lukaskaplan/FireTruck/arduino-shield/PCB_bottom.png

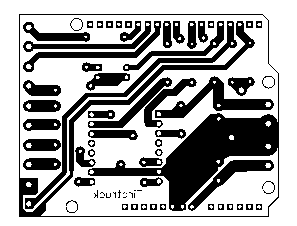
arduino-shield/PCB_bottom.png
