lukaskaplan/FireTruck/(threads)

Thread 1 (2019-04-08):

Horn does not work after engine sound stops.

lukaskaplan, 2019-04-08:
Dfplayer "advert" does not play sound if there is nothing playing in the background (engine sound in this case). Solution can be play engine sound in loop.
