lukaskaplan/FireTruck/arduino-shield/Schematic_Firetruck - arduino uno shield.pdf

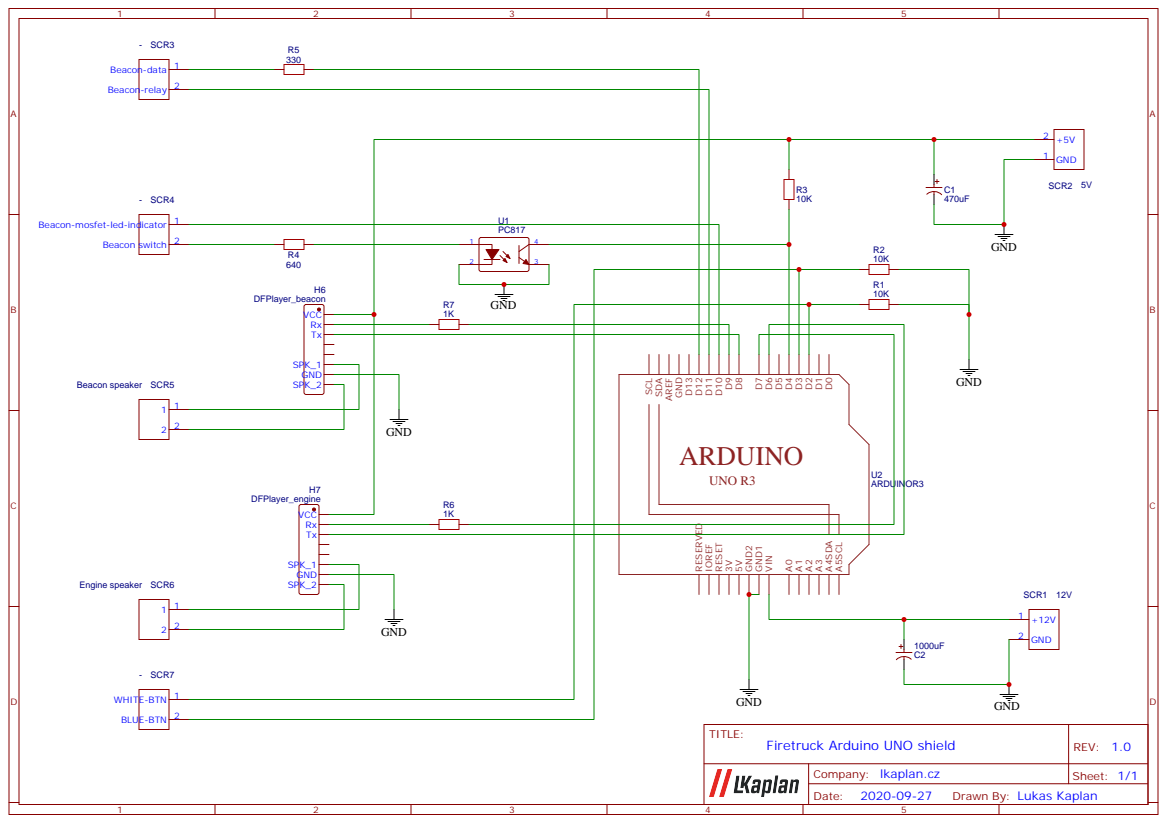
[picture p24: page 1]

Beacon-mosfet-led-indicator 1

Drawn By: Lukas Kaplan
