lukaskaplan/FireTruck/schematics/FireTruck-schematics.pdf

# Rear lights

# Rear inside lights

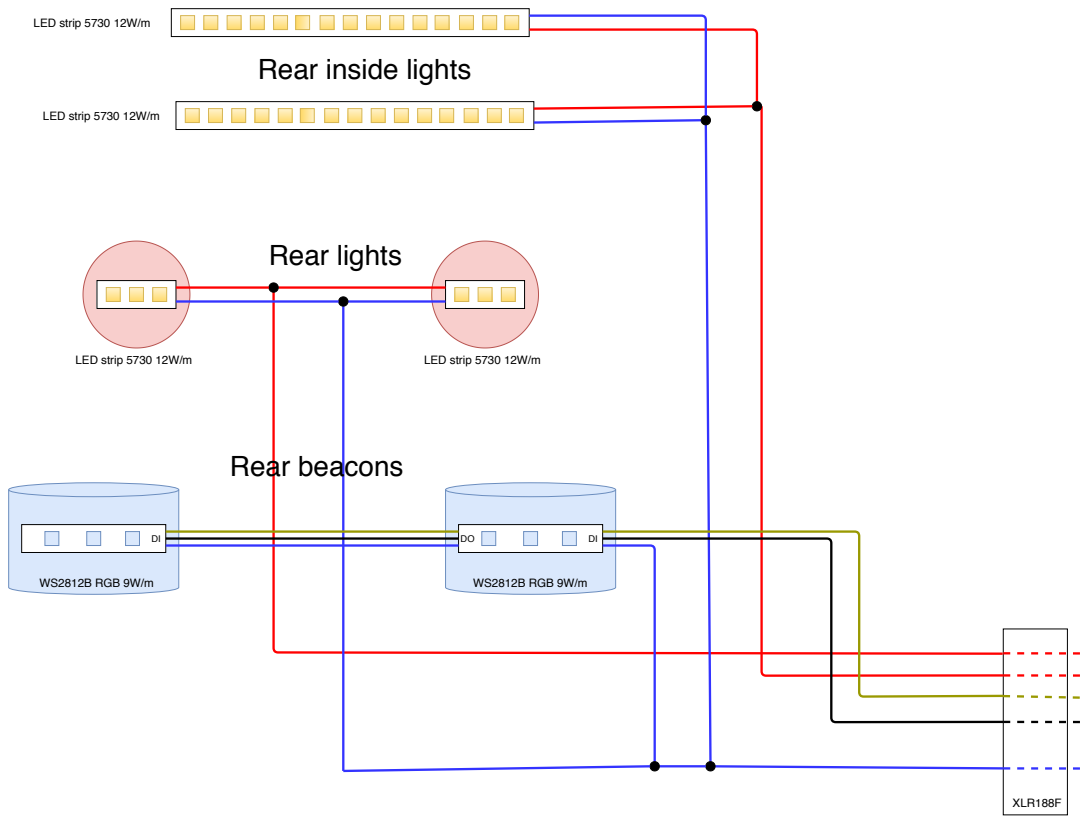
[picture p25: page 1]
WS2812B RGB 9W/m; Rear beacons; XLR188F; LED strip 5730 12W/m

# Front lights

# Front inside light

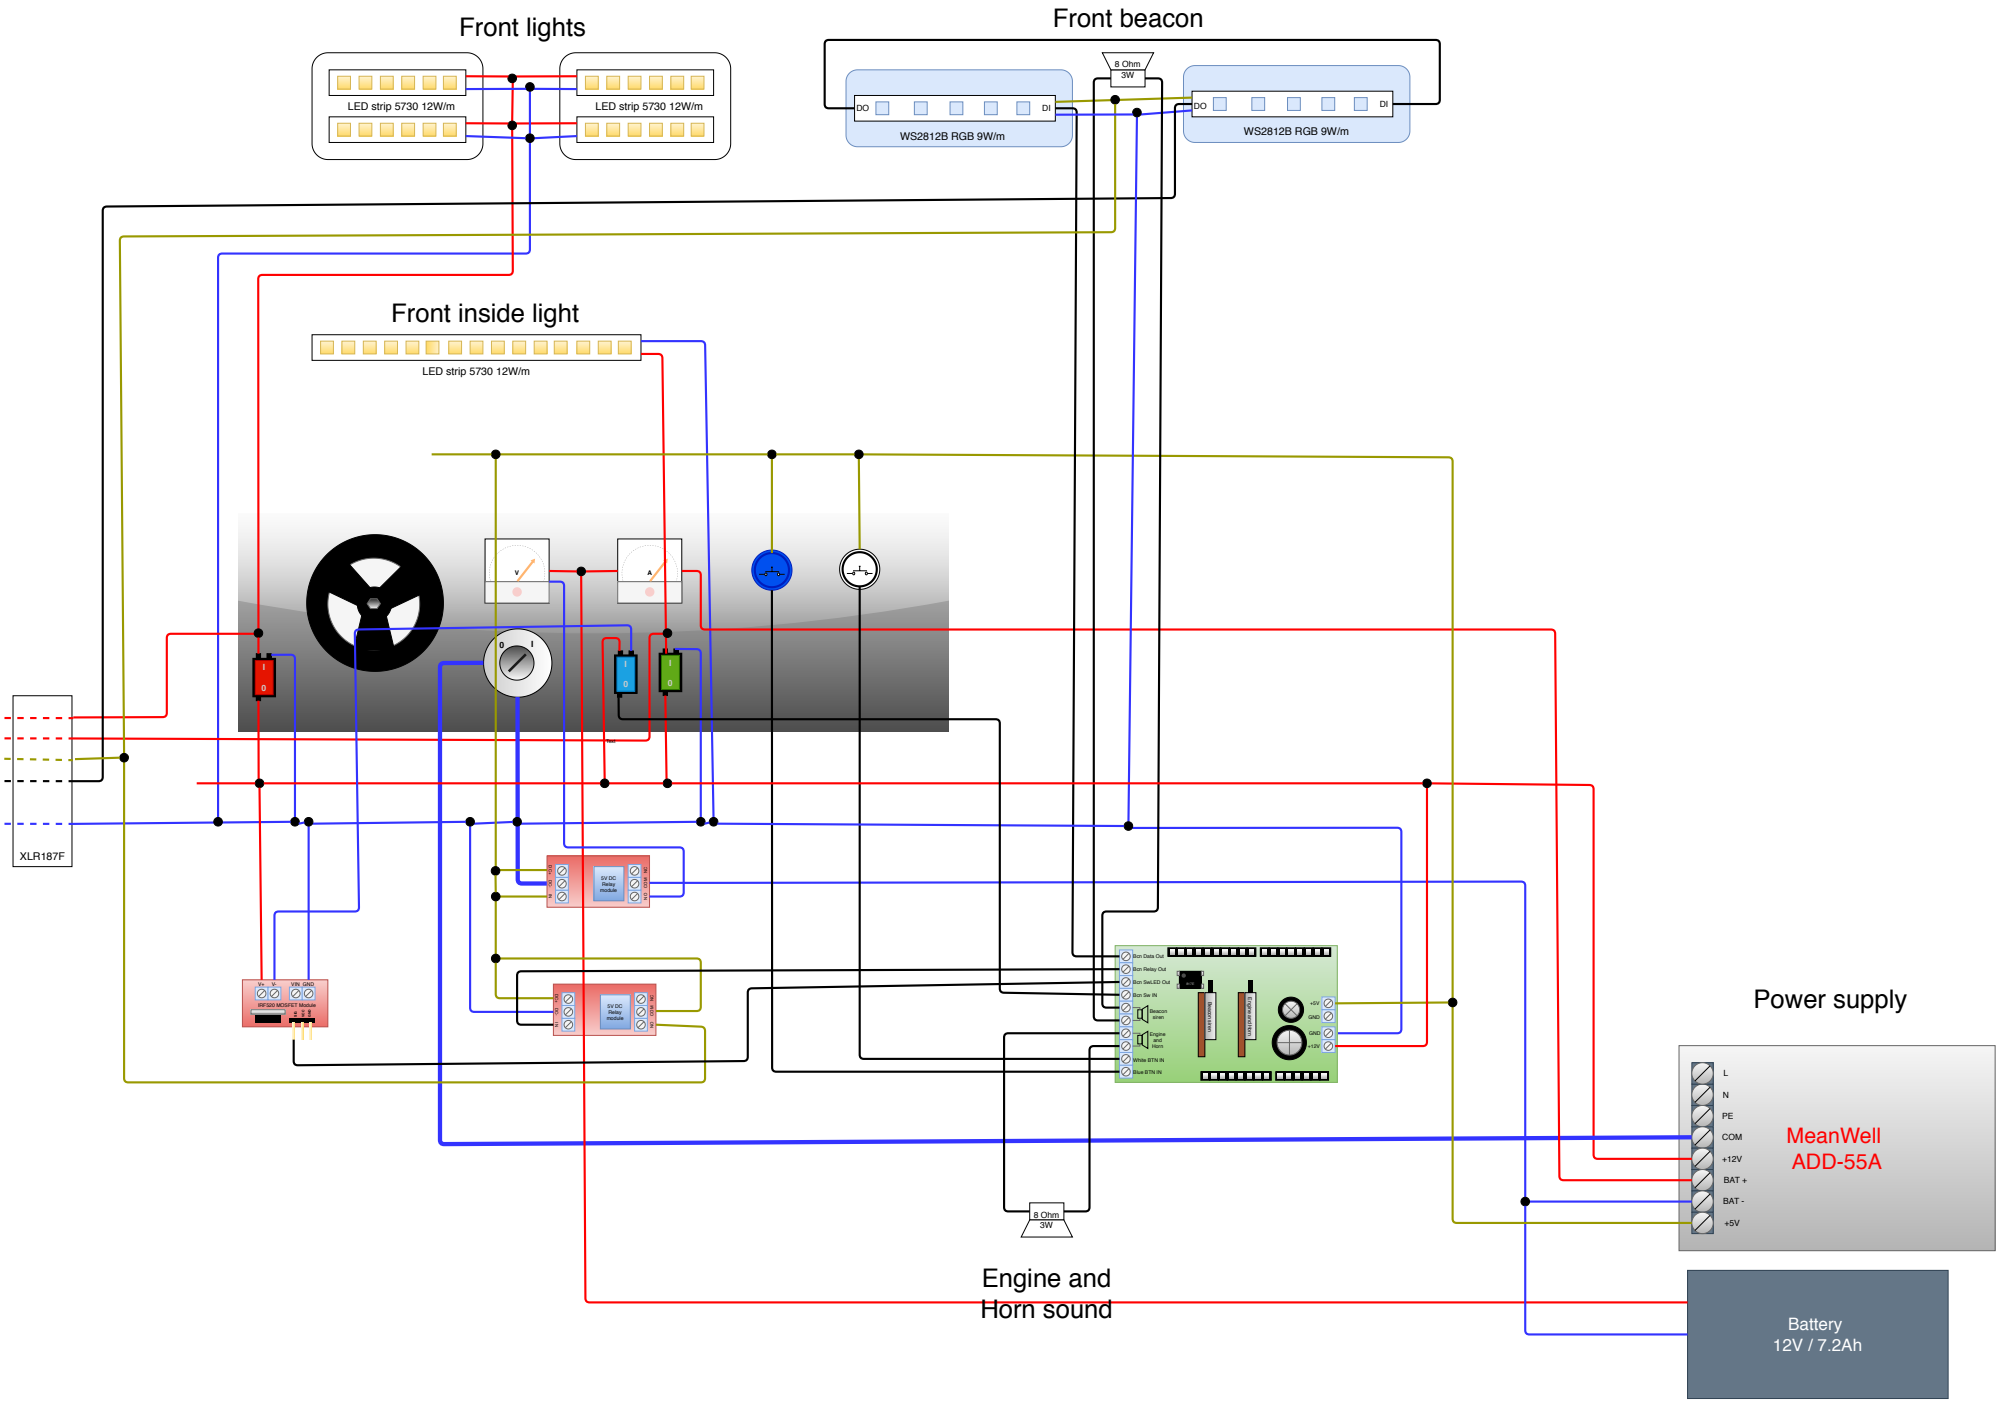
[picture p26: page 2]
MeanWell ADD-55A; COM; BAT +; BAT -; 5V DC Relay module; IRF520 MOSFET Module; VIN GND SIG; VCC; GND; Battery 12V / 7.2Ah; LED strip 5730 12W/m; WS2812B RGB 9W/m; 8 Ohm 3W; Beacon siren; Engine and Horn; Text; Front beacon; XLR187F; Engine and Horn sound; Power supply

COM NO NC

Bcn Data Out

Bcn Relay Out

Bcn SwLED Out

Bcn Sw IN

Engine and Horn

White BTN IN

Blue BTN IN
