lukaskaplan/FireTruck/arduino-shield/PCB_botom.pdf

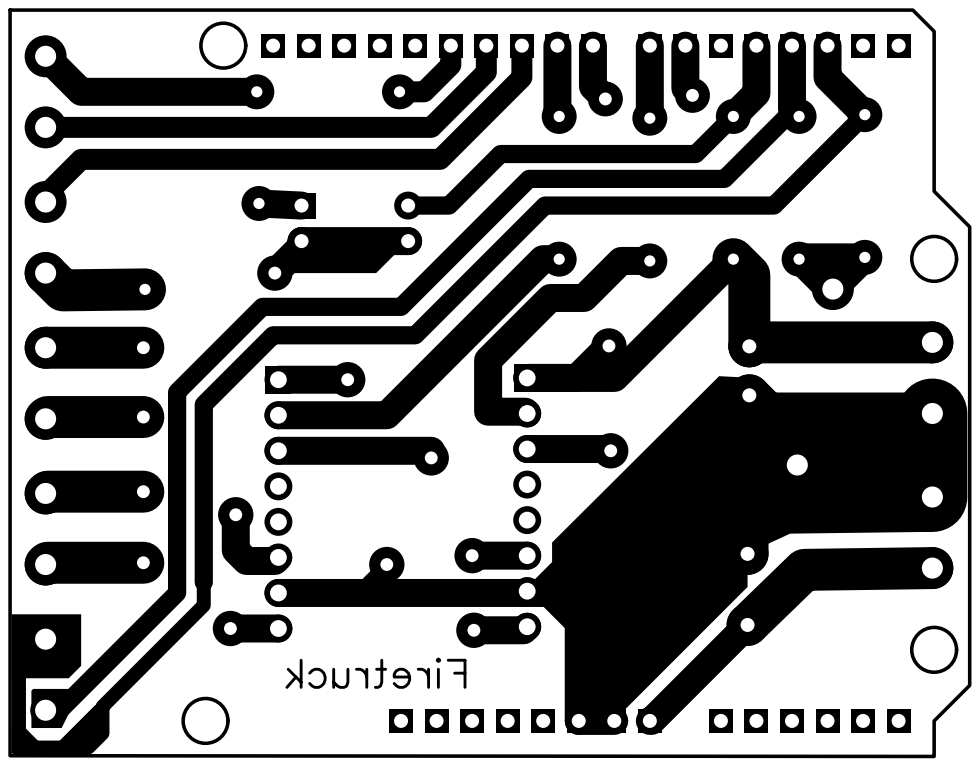
[picture p27: page 1]
