lukaskaplan/FireTruck/arduino-shield/PCB_top_silk.pdf

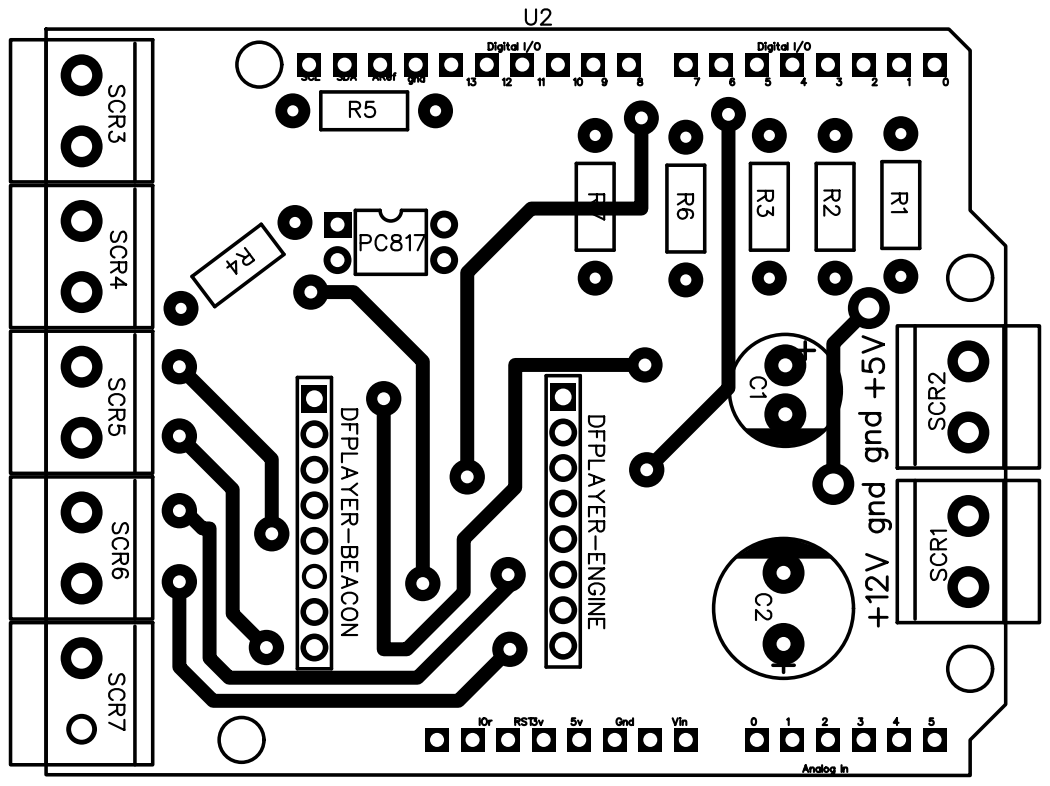
[picture p28: page 1]
