lukaskaplan/FireTruck/(list of files, drawings)

Other design files:
arduino-shield/Firetruck - arduino uno shield - EasyEDA_export.json
